LyleHarlow/LoRa_Level_Temp/hardware/TV Tilt&Temp Using Heltec WiFi LoRa OLED.pdf

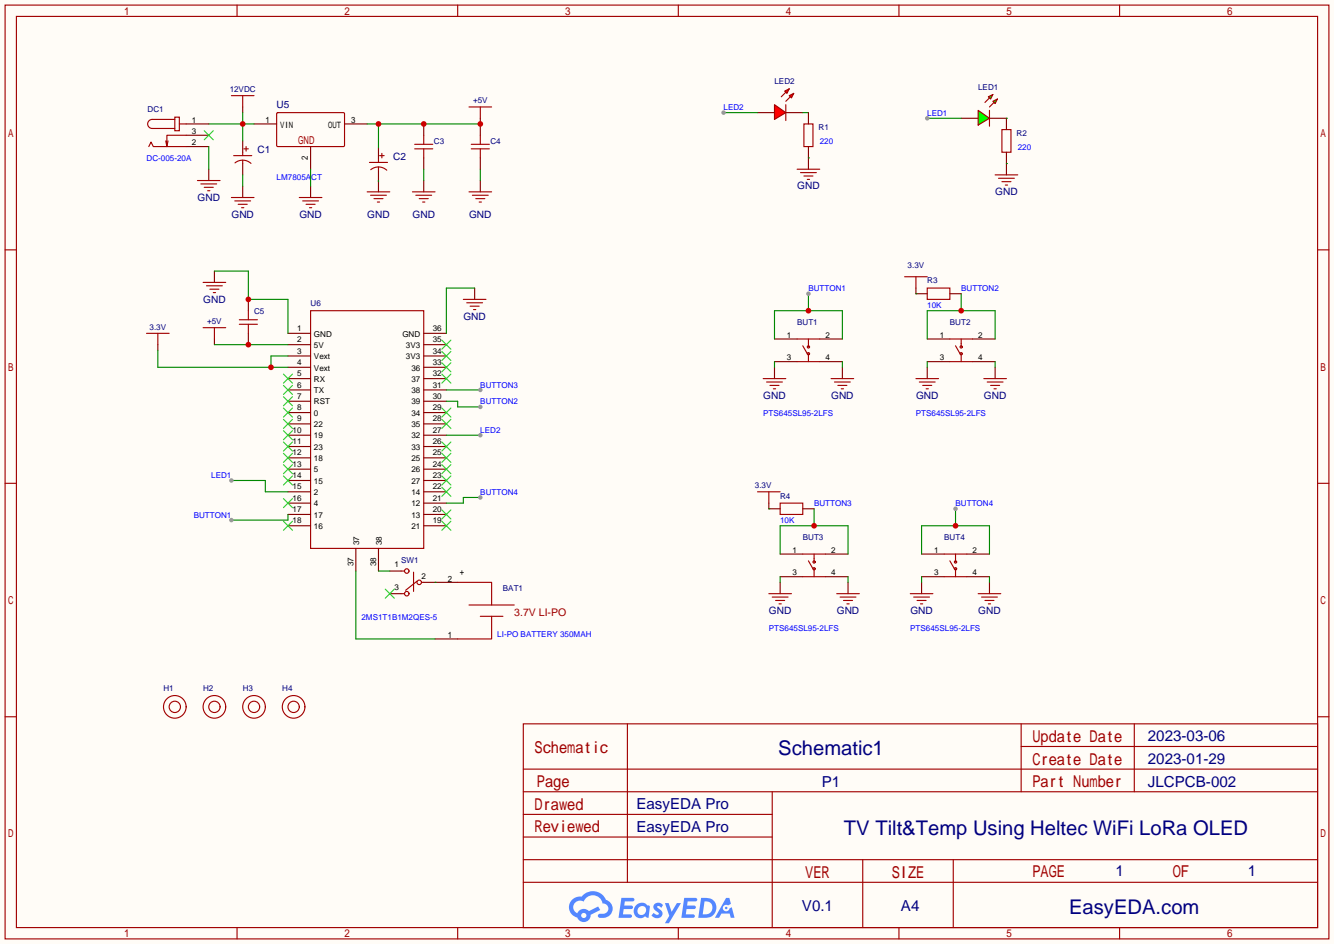
[picture p1: page 1]

2023-01-29 Schematic1
TV Tilt&Temp Using Heltec WiFi LoRa OLED
