LyleHarlow/LoRa_Level_Temp/hardware/V2.1Tilt&TempHeltecWiFiLoRaTouchLCD.pdf

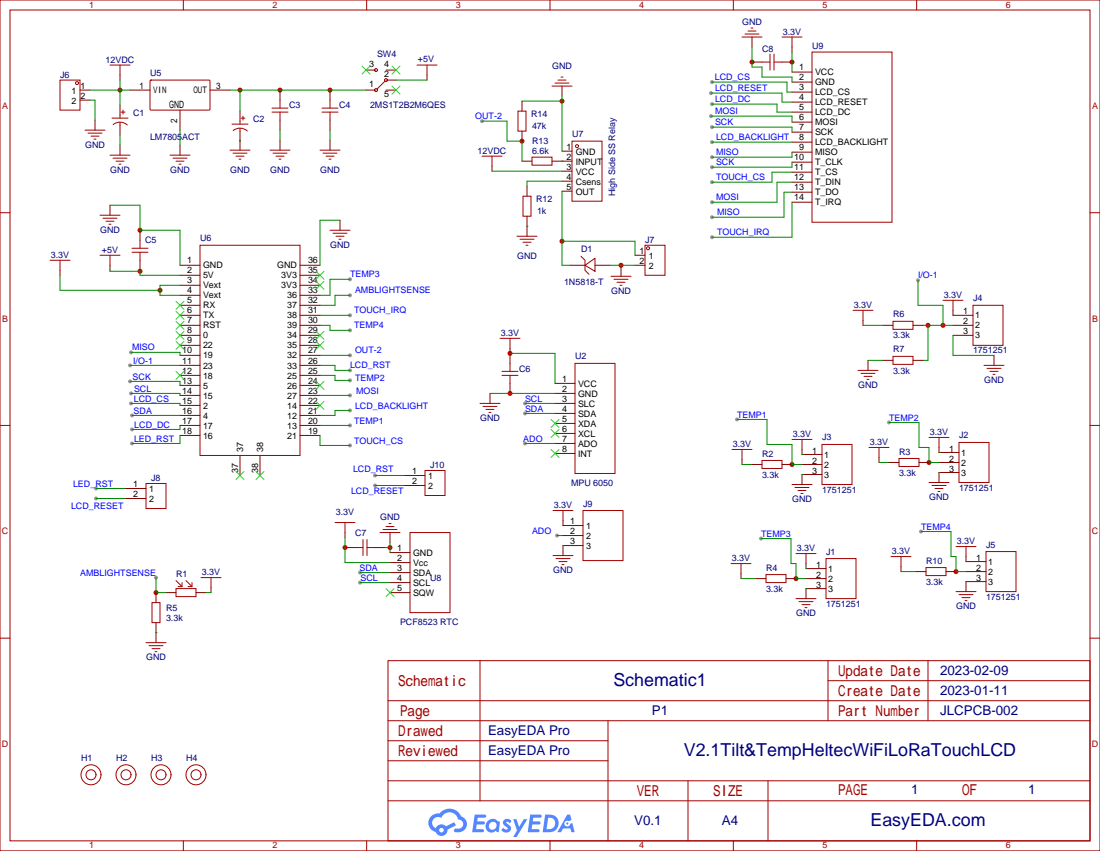
[picture p2: page 1]

High Side SS Relay
