LyleHarlow/LoRa_Level_Temp/(commit log)

2023-01-28 Created TestIO.ino
    Created TestIO.ino to test IO functionality before spinning PCB
2024-01-08 Testing RTC and Gyro
2024-02-05 Changed I2CADDR_DEFAULT from 0x68 to 0x69
    Works with hardware at 0x69 and this address change as well as address change in Tilt_Temp_Airstream.ino of const int MPU_addr=0x69; // Moved to allow other device at 0x68
2024-02-05 Arduino does not like using local version of library.
    I suspect that there is some hard linked reference to the old library somewhere causing trouble.
2026-07-24 Add PCB schematics for TowVehicle and Airstream v2.1 boards
    Both boards have moved from the original TTGO to Heltec WiFi LoRa 32
    OLED modules. The Airstream board adds a touchscreen LCD, RTC, ambient
    light sensor, and relay output, and switches temp sensing from DS18B20
    to analog NTC thermistors.
2026-07-24 Fix TowVehicle schematic: LED2 was on input-only GPIO36
    Corrected schematic moves LED2 from GPIO36 (ADC1_CH0, input-only,
    can't drive an output) to GPIO32, catching the error before fab.
2026-07-25 Rewrite firmware for Heltec v2.1 hardware: tilt, temps, touch UI, LoRa
    Fresh sketches for both boards targeting the redesigned Heltec WiFi LoRa
    32 V2 hardware (old code targeted the original TTGO-based boards):
    - Tilt_Temp_AirStream: MPU6050 tilt (0x69, avoids RTC address collision),
    4x NTC thermistor temps (fridge/freezer/inside/DC cabinet), touchscreen
    info display with a zero-calibration button (persisted to flash), LoRa
    transmit. Fridge-fan relay logic dropped -- no longer needed since the
    trailer's fridge is now self-cooling 12VDC; OUT-2 is left idle.
    - Tilt_Temp_TowVehc: LoRa receive, OLED display with 3 button-cycled
    screens (level/temps/link status), heartbeat + link-lost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
    [AxisOrientationTest.ino, LoRaPacket.h, Tilt_Temp_AirStream.ino, Tilt_Temp_TowVehc.ino]
2026-07-25 Switch TowVehicle to Heltec's official library; fix temp probes to DS18B20
    - Tilt_Temp_TowVehc now uses Heltec ESP32 Dev-Boards (Heltec.begin/
    display/LoRa) instead of raw ESP32 + Adafruit_SSD1306 + sandeepmistry
    LoRa. This also properly powers the OLED via Vext, which the previous
    version never did. Tilt_Temp_AirStream deliberately keeps its manual
    setup -- Heltec's Vext handling claims GPIO21, which is TOUCH_CS there.
    - Temp probes are DS18B20 (OneWire), not NTC thermistors as the schematic's
    resistor topology suggested -- corrected to match the original code's
    approach and the actual hardware (BOJACK DS18B20 stainless probes).
    Reads are now non-blocking (request/collect stat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
    [Tilt_Temp_AirStream.ino, Tilt_Temp_TowVehc.ino]
2026-07-25 Derive real tilt axis formulas from AxisOrientationTest.ino results
    Empirical testing on the physically-mounted board found: roll (left
    up/down) tracks atan2(ax,ay), reading 90 deg at level; pitch (nose
    up/down) tracks raw Z, for which atan2(az, sqrt(ax^2+ay^2)) is the
    equivalent well-behaved angle. Sign direction still needs a quick
    physical check (PITCH_SIGN/ROLL_SIGN), noted in the code.
2026-07-25 Fix PROGMEM undefined error in vendored UI_Fonts.h on ESP32
    Heltec's ESP32 core (3.3.8) doesn't expose PROGMEM to plain .c
    translation units via Arduino.h, only .cpp -- UI_Fonts.c/.h are .c,
    so PROGMEM was an unknown identifier there. PROGMEM is a no-op on
    ESP32 regardless (flash is memory-mapped, unlike AVR), so a fallback
    empty definition is safe.
2026-07-25 Ignore Library-Manager-installed libraries under libraries/
    Sketchbook location now points at this repo's root, so Arduino
    Library Manager installs (Adafruit_*, LoRa, OneWire, DallasTemperature,
    Heltec_ESP32_Dev-Boards, etc.) land in libraries/ alongside our vendored
    TouchUserInterfaceForArduino. Only the latter is ours to track.
2026-07-25 Lower LoRa TX power to fix display flicker during transmit
    Diagnosed by temporarily disabling transmitPacket(): the flicker
    stopped, confirming LoRa TX (not a chip reset -- Serial output was
    clean throughout) was the trigger. LoRa.begin() defaults to 17dBm via
    PA_BOOST, drawing a current spike large enough to sag the shared 3.3V
    rail and visibly disrupt the LCD, even on a proper 15W 12VDC supply.
    Dropped to 2dBm, plenty for a trailer-to-tow-vehicle link.
    [Tilt_Temp_AirStream.ino]
2026-07-25 Add last-updated header and diagnostics for blank-screen investigation
    - Last-updated timestamp comment at top of file, per user request, so
    they can confirm they're looking at the current version.
    - Setup() now prints a checkpoint after each major init step (tilt
    sensor, temp sensors, LoRa, ui.begin) to narrow down where things
    stand if something silently hangs or fails.
    - Proper LOW-then-HIGH hardware reset pulse on LCD_RST instead of just
    driving HIGH once.
    - Temporary diagnostic: fills the whole screen red right after
    ui.begin() to test whether the LCD driver can put anything on screen
    at all, independent of the menu/label drawing code.
    [Tilt_Temp_AirStream.ino]
2026-07-25 Fix crash: disable analogRead(AMBLIGHTSENSE_PIN), it faults the ADC driver
    Symbolized the crash dump the user captured (EXCCAUSE 6, IntegerDivideByZero)
    using xtensa-esp32-elf-addr2line against the build's .elf with debug
    symbols. Backtrace pinned it exactly: analogRead(GPIO37) in
    drawInfoScreenValues() -> adc_oneshot_read -> adc_oneshot_hal_convert ->
    adc_oneshot_ll_get_event, faulting inside ESP-IDF's ADC HAL. Since
    drawInfoScreenValues() runs every loop iteration, this crashed the board
    on essentially the first loop, well before anything could render --
    explaining the persistent blank screen (the reboot loop was too fast to
    see, not an absence of activity).
    GPIO37 was flagged early in th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
    [Tilt_Temp_AirStream.ino]
2026-07-25 Add minimal standalone ILI9341 test sketch for blank-screen diagnosis
    Talks to Adafruit_ILI9341 directly with nothing else running (no LoRa,
    MPU6050, or TouchUserInterfaceForArduino) to isolate whether the LCD
    hardware/wiring works at the most basic level, independent of any
    interaction with the rest of the Airstream sketch.
2026-07-25 Fix LCD reset pin: GPIO16 (LED_RST), not GPIO33 (LCD_RST)
    The user confirmed LCD_RESET is physically jumpered to the LED_RST net
    (GPIO16), not the LCD_RST net (GPIO33) -- both exist on the schematic
    but only one is actually bridged to the panel's reset pin. Code was
    toggling GPIO33, which isn't connected to anything, leaving the real
    reset pin floating/undriven the whole time. Very likely the actual
    cause of the persistent blank screen: a panel stuck in an undefined
    reset state would ignore all commands while still accepting SPI
    transactions without error, matching everything observed so far.
    [LCDTest.ino, Tilt_Temp_AirStream.ino]
2026-07-25 Remove temporary red-fill diagnostic, confirmed fixed via LCDTest.ino
    LCD_RST pin fix (GPIO16, not GPIO33) confirmed working: LCDTest.ino now
    shows colors correctly. Removing the diagnostic screen fill from the
    main sketch since it already found what it was looking for; keeping
    the setup() checkpoint prints as ordinary boot logging.
    [Tilt_Temp_AirStream.ino]
2026-07-25 Fix Zero Level button overlapping the Light row
    Confirmed via a photo of the working display: the button (fixed at
    centerY=210) overlapped the 7th label row. Reworked layout to use the
    library's actual displaySpaceTopY/BottomY/LeftX/RightX bounds (title
    bar is a fixed 34px per TouchUserInterfaceForArduino.cpp) instead of
    guessed pixel offsets, tightened row spacing (26->22px), and anchored
    the button to the bottom-right of the display space so it can't
    overlap the rows regardless of exact screen dimensions.
    [Tilt_Temp_AirStream.ino]
2026-07-25 Remove Light row from display, photoresistor not installed yet
    Screen now shows 6 rows (tilt + 4 temps) instead of 7. AMBLIGHTSENSE_PIN
    constant left as a comment for when the sensor is physically installed.
2026-07-25 Add diagnostics for stack-smashing crash in ui.drawButton()
    Symbolized the new crash dump (stack canary failure) to
    TouchUserInterfaceForArduino::drawButton(), called from
    drawInfoScreenLayout(). Library-internal buffer handling looks
    bounds-safe on read-through -- adding prints of the actual computed
    button/display-space values to see what's really being passed in
    before chasing further.
    [Tilt_Temp_AirStream.ino]
2026-07-25 Add uptime-seconds diagnostic to Nose Up/Down row
    Temporary: appends "(Ns)" using millis()/1000, which must visibly tick
    every second regardless of sensor values. Tests whether the reported
    "screen values aren't changing" is drawInfoScreenValues() not actually
    running, versus the underlying data (pitch/roll static because the
    board is stationary in a vise, t3/t4 showing the disconnected
    placeholder, t1/t2 drifting slowly enough to look static at a glance).
    [Tilt_Temp_AirStream.ino]
2026-07-25 Fix angle-averaging wraparound bug; remove resolved diagnostics
    Confirmed display redraw and drawButton() crash are both fully fixed
    (user tested). Cleaning up their temporary diagnostics.
    Real bug found in the process: smoothing averaged the *computed*
    pitch/roll angles over the 8-sample window, which breaks near the
    atan2 wraparound point -- e.g. averaging readings near -179 deg and
    +179 deg (physically ~2 deg apart) naively gives ~0 deg. This produced
    a bogus 204 deg roll reading during bench testing while the board was
    being rotated. Fixed by averaging the raw accelerometer vector
    (ax/ay/az) instead, and computing the angle once from the averaged
    vector -- raw accelerations have no wrap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
    [Tilt_Temp_AirStream.ino]
2026-07-25 Document Heltec ESP32 Dev-Boards SpiInOut compile fix
    sx1276.c calls SpiInOut() without a prototype (sx1262-board.c has the
    equivalent extern declaration; sx1276.c is missing it upstream). GCC 14
    (this toolchain) errors on implicit function declarations by default,
    where older compilers only warned. Patched the local install directly,
    but that library is gitignored (Library Manager install, not vendored),
    so documenting the one-line fix in the README in case it needs
    reapplying after a future reinstall.
2026-07-25 Document second Heltec ESP32 Dev-Boards bug: null display pointer
    Symbolized a runtime crash in Tilt_Temp_TowVehc (EXCVADDR 0x14, classic
    null-pointer-plus-offset) to Heltec_ESP32::begin() -> ScreenDisplay::init().
    Root cause: heltec.h defines Class_WIFI_LORA (all-caps), but heltec.cpp's
    constructor checks the differently-cased Class_Wifi_LoRa, which is never
    defined -- so `display` is never allocated even though Heltec_Screen
    (correctly cased) still lets begin() call display->init() on it. Patched
    locally and documented alongside the SpiInOut fix, since this library
    isn't tracked in git.
2026-07-25 Document third Heltec ESP32 Dev-Boards bug: wrong SSD1306Wire args
    Blank OLED with no errors anywhere, even after the null-pointer fix.
    SSD1306Wire's constructor is (address, freq, sda, scl, geometry, rst),
    but heltec.cpp calls it with 5 positional args matching an older
    signature -- SDA_OLED lands in the freq parameter, SCL_OLED in sda,
    RST_OLED in scl, and the real reset pin never gets passed at all.
    Wire.begin() ends up running on the wrong physical pins at a ~4Hz
    clock. Nothing in this path checks I2C ACKs, so every call reports
    success while nothing reaches the display. Patched both constructor
    call sites (128x64 and 64x32 variants) and documented since this
    library isn't tracked in git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
2026-07-25 Fix LoRa link: explicitly match radio params on both boards
    Root cause of TowVehicle never receiving anything despite confirmed
    Airstream TX: the two sketches use different LoRa library
    implementations (sandeepmistry/LoRa on Airstream, Heltec's vendored
    fork via Heltec.LoRa on TowVehicle) with different implicit defaults.
    Heltec's begin() explicitly sets spreading factor 11 and sync word
    0x34; sandeepmistry's begin() sets neither, leaving the SX1276 at its
    power-on defaults (SF7, sync word 0x12). Two radios on different
    spreading factors/sync words can't decode each other's packets at
    all, with no error on either side -- just silence.
    Made both sketches set spreading factor, bandwidth, sync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
    [Tilt_Temp_AirStream.ino, Tilt_Temp_TowVehc.ino]
2026-07-25 Reword tilt display: direction words instead of signed numbers
    "Front to Back: Nose High/Nose Low" and "Left/Right: Left High/Right
    High" replace "Nose Up/Down"/"Left Up/Down" with a signed number --
    easier to act on at a glance, and sets up cleanly for the eventual
    degrees-to-inches conversion once real measurement data exists.
    Applied consistently to both the Airstream touchscreen and TowVehicle
    OLED. Also added a Last-updated timestamp header to
    Tilt_Temp_TowVehc.ino, matching Tilt_Temp_AirStream.ino.
    [Tilt_Temp_AirStream.ino, Tilt_Temp_TowVehc.ino]
2026-07-25 Wire in PCF8523 RTC alongside MPU6050 on the shared I2C bus
    Adafruit's RTClib (RTC_PCF8523::begin(TwoWire*)) accepts an
    already-configured Wire instance and depends on the same Adafruit
    BusIO already used by Adafruit_MPU6050 -- no library conflict once
    Wire.begin(SDA_PIN, SCL_PIN) is called exactly once (already was, for
    the MPU6050) and each library's begin() is passed that same &Wire.
    The user's earlier "RTC and MPU6050 don't work together" issue was
    likely a combination of the I2C address collision (already fixed via
    the ADO jumper this session) and testing against a PCF8563-oriented
    library for what's actually PCF8523 hardware in the old 2019-era code.
    Falls back to compile time if the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
    [Tilt_Temp_AirStream.ino]
2026-07-26 Add touch menu system: Level, Temps, Fan Control, Settings screens
    Replaces the single flat info screen with a real menu (mainMenu[] +
    ui.displayAndExecuteMenu(), first use of TouchUserInterfaceForArduino's
    menu system in this project, modeled on the library's own
    Example01_SimpleMenu/Example06_GetNumbersAndValues):
    - Level: tilt readout + time (read-only)
    - Temps: 4 probes + time (read-only)
    - Fan Control: SELECTION_BOX probe picker, NUMBER_BOX_FLOAT min/max
    thresholds, SELECTION_BOX schedule enable + NUMBER_BOX start/end hour.
    Revives the OUT-2 relay (previously held idle/deferred) with a
    hysteresis thermostat gated by an optional time window
    (updateFanControl()). Every change per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
    [Tilt_Temp_AirStream.ino]
2026-07-26 Fix compile error: forward-declare menu command functions
    Arduino's auto-prototype generation didn't pick up commandLevel/
    commandTemps/commandFanControl/commandSettings when they're only
    referenced inside the mainMenu[] initializer -- declared explicitly,
    same treatment the array itself already gets via extern MENU_ITEM
    mainMenu[].
    [Tilt_Temp_AirStream.ino]
2026-07-26 Fix Fan Control screen garbling and a real null-pointer bug
    Root cause of the garbled Probe selector: SELECTION_BOX.width is the
    TOTAL width, split evenly across all choice cells, not the width of a
    single cell (confirmed in getCoordsOfSelectionBoxCell()). Cramming a
    4-choice selector into a half-screen column left each cell ~34px wide,
    nowhere near enough for "Freezer"/"Inside AS" text. Gave Probe its own
    full-width row; Schedule (2 choices) also moved to full width, Min/Max
    Temp and Start/End Hour stay 2-column (NUMBER_BOX degrades gracefully
    at narrow widths via its own min-width clamps, unlike SELECTION_BOX).
    Also fixed a genuine bug alongside the layout issue: fanScheduleBox's
    unused c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
    [Tilt_Temp_AirStream.ino]
2026-07-26 Document the arduino-cli test-compile setup
    Arduino IDE 2.x bundles its own arduino-cli with a config file already
    pointed at this repo's sketchbook location -- no separate setup
    needed. Worth recording since it's the first time this project could
    be compiled outside the IDE, and a standalone arduino-cli download got
    blocked by a system policy earlier in this project's history.
2026-07-26 Fix Level screen freezing after a true power cycle (works after reflash)
    User's report was the key clue: Level works after uploading via USB,
    but freezes/never updates after a real power cycle. A USB-triggered
    reset/reflash doesn't actually remove power from the board (only the
    ESP32 CPU resets) -- the MPU6050 stays "warm" between resets. A true
    power cycle drops power to everything, and the MPU6050 needs a brief
    settling time after power-up before it reliably ACKs on I2C.
    setupTiltSensor() previously called mpu.begin() once and, on failure,
    just logged a warning and kept going -- leaving mpu in a
    never-initialized state that reads back stuck/frozen values forever,
    exactly matching the repo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
    [Tilt_Temp_AirStream.ino]
2026-07-26 Add I2C bus scan diagnostic; make failed MPU6050 init visible as NAN
    The 5-retry/1s fix wasn't enough -- user's boot log showed mpu.begin()
    failing on every single attempt, not just the first one or two, ruling
    out a brief settling delay as the whole explanation. Extended the
    retry window to 15 attempts/300ms (~4.5s) and added a full I2C bus
    scan at attempts 1/5/10/15, to see directly whether nothing responds
    at all during a failed cold boot (bus-wide power/pull-up issue) or
    specifically just the MPU6050's address (0x69, which depends on the
    ADO jumper reading a stable HIGH -- unlike the RTC's hardwired 0x68).
    Also: updateTilt() previously kept reading from mpu even after
    mpu.begin() never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
    [Tilt_Temp_AirStream.ino]
2026-07-26 Fix EEPROM/NVS crash and settings not persisting across power cycle
    EEPROM.begin() crashed (LoadProhibited) creating the "eeprom" NVS blob
    from total nonexistence, even after a full flash erase -- worked
    around by pre-creating the key via the raw NVS API when absent.
    Separately, TouchUserInterfaceForArduino's ESP32 writeConfigurationInt/
    Float never call EEPROM.commit() (unlike their RP2040 counterparts), so
    Zero Level and fan control settings were never actually saved. Added
    flushEepromToFlash() (EEPROM.commit() + nvs_commit()) after every write
    call site. Both confirmed fixed on hardware through a true power cycle.
    [Tilt_Temp_AirStream.ino]
2026-07-27 Redesign Airstream menu screens; fix LoRa blocking send and I2C crash recovery
    UI: bigger back button (titleBarHeight bump, vendored library), larger
    fonts on Level/Temps with a consistent blue/white look, Settings and Fan
    Control each split into focused sub-screens (Date/Time, Probe/Temp
    Range/Schedule Hours) so every screen has room to breathe, 12-hour AM/PM
    time entry and display throughout, yellow selection highlights matching
    across screens.
    Bug fixes found along the way:
    - Roll could read e.g. "252 degrees" -- ROLL_FROM_AXES's atan2()-90 shifts
    the bounded angle range asymmetric; normalize to (-180,180] after offset.
    - Set Date could load garbage (month 160) from a glitched RTC read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
    [Tilt_Temp_AirStream.ino]
2026-07-27 Extend LoRa packet with date/time and fan status; update TowVehicle display
    LoRaPacket gains year/month/day/hour/minute and fanOn/fanProbeIndex/
    fanOffTemp/fanOnTemp/fanStartHour/fanEndHour, populated by Airstream's
    transmitPacket() from the RTC and current fan settings.
    TowVehicle: Level screen wording now matches the Airstream (Front/Back,
    Left/Right, Right Low/Left Low) and drops date/time to stay readable on
    the small OLED; LoRa Link screen gains compact date/time; new Fan screen
    shows on/off state, probe, off/on temps, and schedule (12-hour format).
2026-07-31 Add SX1262 support for V3 TowVehicle boards via RadioLib
    Heltec.begin()'s bundled LoRa driver only supports SX127x, so V3
    (SX1262 radio) drives the radio directly through RadioLib instead,
    matched to the Airstream's classic-LoRa.h radio config (including a
    forced-off LDRO to match that library's integer-truncation quirk, and
    a readData() CRC check that was previously missing). Also corrects
    the V3 carrier-board pin table against real hardware (LED2 was wired
    to GPIO39, not the derived GPIO40, which was causing a dim idle glow)
    and adds TX/RX raw-byte diagnostics used to track down the corruption.
    [Tilt_Temp_AirStream.ino, Tilt_Temp_TowVehc.ino]
2026-08-02 Remove unusable temp3/4 probes, fix RTC/MPU6050 diagnostics, add angle-to-inches leveling
    temp3/temp4 were wired to GPIO36/39 on the Airstream's ESP32, which are
    input-only pins that can't drive the OneWire bus low -- confirmed on
    hardware they can never work, so they're removed from LoRaPacket, sensor
    reads, and both boards' UI. Fan Control's probe choices are now just
    Fridge/DC Cabinet (temp2 renamed from Freezer).
    Also, from chasing a cold-boot MPU6050/-nan report: added a WHO_AM_I
    register readback when mpu.begin() fails (address ACKs fine per the
    existing I2C scan, so begin() must be failing a deeper check), and caught
    a real PCF8523 gap where initialized()/lostPower() can both report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
    [LoRaPacket.h, Tilt_Temp_AirStream.ino, Tilt_Temp_TowVehc.ino]
